freedom8623/DIY_humidifier/外壳/图片/外壳3.jpg

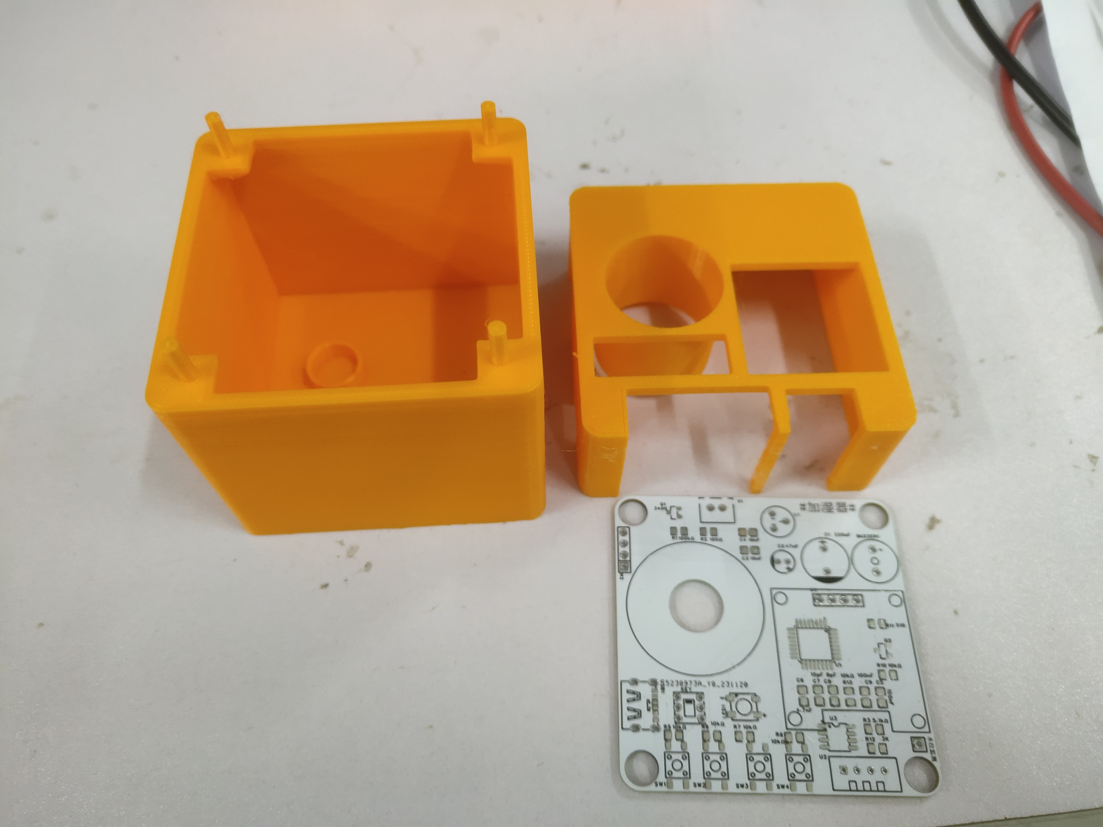
外壳/图片/外壳3.jpg
