freedom8623/DIY_humidifier/外壳/图片/外壳4.jpg

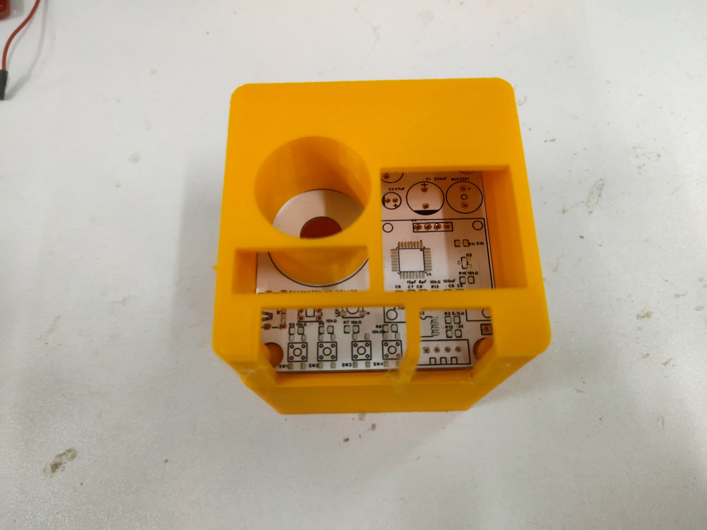
外壳/图片/外壳4.jpg
