freedom8623/DIY_humidifier/外壳/图片/外壳1.jpg

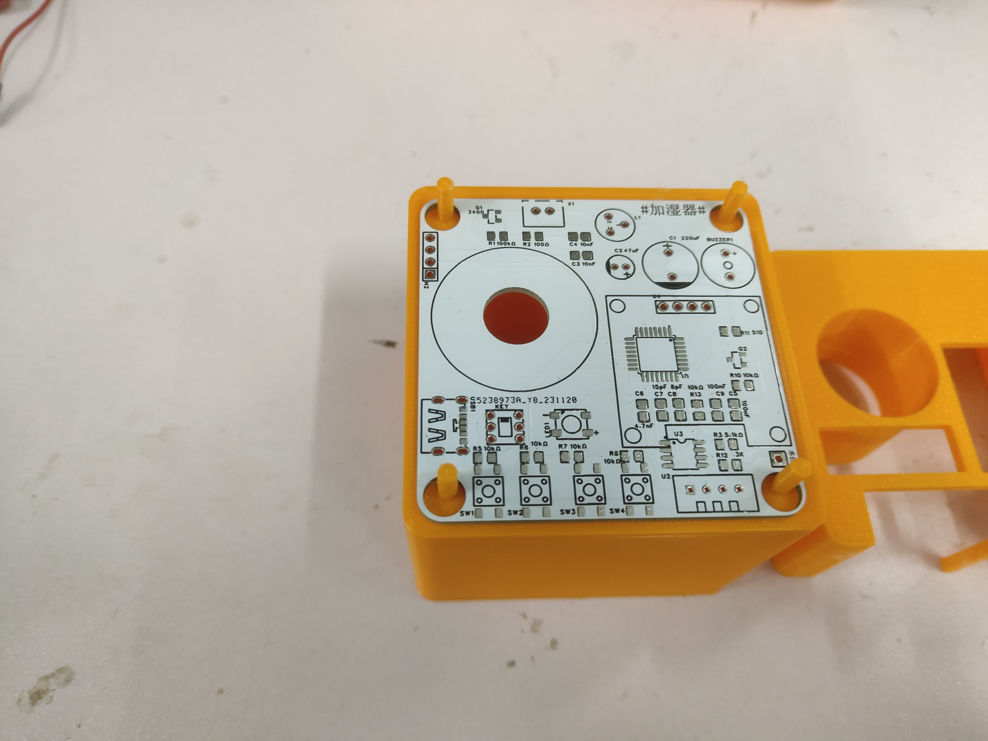
外壳/图片/外壳1.jpg
