freedom8623/DIY_humidifier/副本加湿器boom表(1).xlsx

No. | Quantity | Comment | Designator | Footprint | Value | Manufacturer Part | Manufacturer | Supplier Part | Supplier
1 | 1 | 3000Hz | BUZZER1 | BUZ-TH_BD9.6-P5.00-D0.7-FD | 3000Hz | HNB09A05 | 华能 | C96493 | LCSC
2 | 1 | 220uF | C1 | CAP-TH_BD10.0-P5.00-D1.0-FD | 220uF | RNG221M1EBK-1012 | lelon(立隆) | C311677 | LCSC
3 | 1 | 47uF | C2 | CAP-TH_BD5.0-P2.00-D0.8-FD | 47uF | 01EC1882SHG47uF16V | KNSCHA(科尼盛) | C503214 | LCSC
4 | 2 | 10nF | C3,C4 | C0805 | 10nF | 0805B103K500NT | FH(风华) | C52278 | LCSC
5 | 1 | 100nF | C5 | C0805 | 100nF | CT41G-0805-2X1-50V-0.1μF-K(N) | TORCH(火炬) | C126469 | LCSC
6 | 1 | 4.7nF | C6 | C0805 | 4.7nF | 0805B472K500NT | FH(风华) | C1744 | LCSC
7 | 1 | 15pF | C7 | C0805 | 15pF | 0805N150J500CT | Walsin(华新科) | C396747 | LCSC
8 | 1 | 8pF | C8 | C0805 | 8pF | 0805CG8R0C500NT | FH(风华) | C1839 | LCSC
9 | 1 | 100nF | C9 | C0805 | 100nF | CC0805KRX7R9BB104 | YAGEO(国巨) | C49678 | LCSC
10 | 1 | 插排 | H2 | HDR-TH_4P-P2.54-V-M |  | PZ254R-11-04P | XFCN(兴飞) | C492412 | LCSC
11 | 1 | 插排 | H3 | HDR-TH_1P-P2.54-V-M |  | PZ254V-11-01P | XFCN(兴飞) | C492400 | LCSC
12 | 1 | XKB5858-Z | KEY | SW-TH_6P-L5.8-W5.8-P2.00-LS4.5-BL |  | XKB5858-Z | XKB Connectivity(中国星坤) | C318868 | LCSC
13 | 1 | 27uH-770uH | L1 | 三脚电感 | 27uH-770uH | PDPTAT0810-2R2M | PROD(谱罗德) |  | LCSC
14 | 1 | XL-5050RGBC-WS2812B | LED1 | LED-SMD_4P-L5.0-W5.0-BL_XL-5050RGBC |  | XL-5050RGBC-WS2812B | XINGLIGHT(成兴光) | C2843785 | LCSC
15 | 1 | AO3400-HXY | Q1 | SOT-23_L2.9-W1.3-P1.90-LS2.4-BR |  | AO3400-HXY | HXY MOSFET(华轩阳电子) | C4748804 | LCSC
16 | 1 | AO3400A | Q2 | SOT-23_L2.9-W1.3-P1.90-LS2.4-BR |  | AO3400A | BORN(伯恩半导体) | C344010 | LCSC
17 | 1 | 100kΩ | R1 | R0805 | 100kΩ | 0805W8F1003T5E | UNI-ROYAL(厚声) | C149504 | LCSC
18 | 1 | 100Ω | R2 | R0805 | 100Ω | 0805W8F1000T5E | UNI-ROYAL(厚声) | C17408 | LCSC
19 | 1 | 5.1kΩ | R3 | R0805 | 5.1kΩ | 0805W8F5101T5E | UNI-ROYAL(厚声) | C27834 | LCSC
20 | 6 | 10kΩ | R5,R6,R7,R8,R10,R13 | R0805 | 10kΩ | 0805W8F1002T5E | UNI-ROYAL(厚声) | C17414 | LCSC
21 | 1 | 510Ω | R11 | R0805 | 510Ω | 0805W8F5100T5E | UNI-ROYAL(厚声) | C17734 | LCSC
22 | 1 | 3kΩ | R12 | R0805 | 3kΩ | 0805W8F3001T5E | UNI-ROYAL(厚声) | C17661 | LCSC
23 | 4 | TS-1009S-03826 | SW1,SW2,SW3,SW4 | SW-SMD_4P-L4.5-W4.5-P3.00-LS7.0 |  | TS-1009S-03826 | XUNPU(讯普) | C455243 | LCSC
24 | 1 | STC8H8K64U-LQFP32-YC | U1 | LQFP-32_L7.0-W7.0-P0.80-LS9.0-BL |  | STC8H8K64U-LQFP32-YC |  | C9900031452 | LCSC
25 | 1 | DHT11 | U2 | SENSOR-TH_DHT11 |  | DHT11 | 广州奥松 | C117051 | LCSC
26 | 1 | TC301D | U3 | SO-8_L4.9-W3.9-P1.27-LS5.9-BL |  | TC301D | NUTECH(诺泰) | C362144 | LCSC
27 | 1 | HS96L03W2C03 | U4 | OLED |  | HS96L03W2C03 | HS(汉昇) | C5248080 | LCSC
28 | 1 | TYPE-C 6P | USB1 | TYPE-C-SMD_TYPE-C-6P |  | TYPE-C 6P | SHOU HAN(首韩) | C456012 | LCSC
29 | 1 | 108KHz | X1 | 雾化片13.mm 108HZ |  | 108KHz | JST | C158012 | LCSC
30 | 1 |  | STM32H7B0VBT6 | https://item.taobao.com/item.htm?spm=a21n57.1.0.0.35c4523crgNStJ&id=732566780970&ns=1&abbucket=0&mt=
