freedom8623/DIY_humidifier/外壳/加湿器底子.SLDPRT

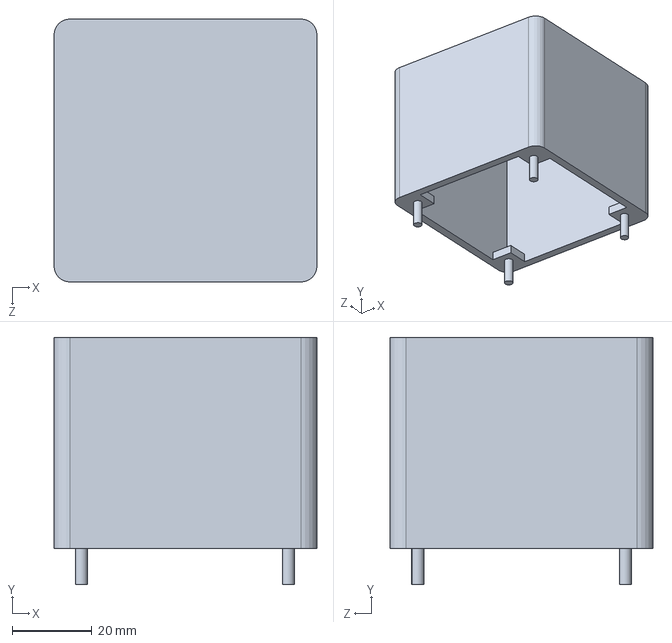
[picture p17: CAD file, 2023-12-03]
外壳/加湿器底子.SLDPRT
66.0 x 62.0 x 66.0 mm
