freedom8623/DIY_humidifier/外壳/加湿器盖子.SLDPRT

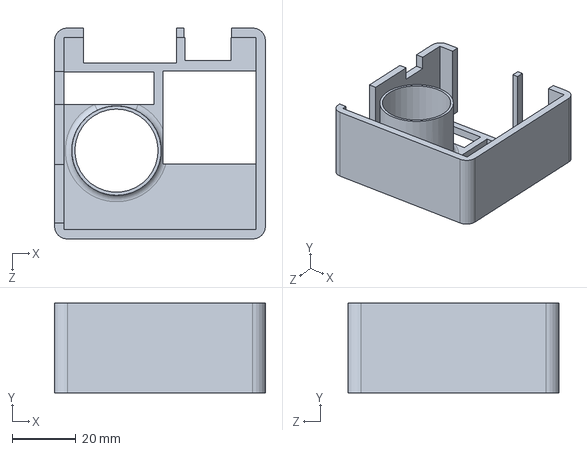
[picture p18: CAD file, 2023-12-03]
外壳/加湿器盖子.SLDPRT
66.0 x 28.0 x 66.0 mm
