freedom8623/DIY_humidifier/(list of files, cad)

Other CAD files:
Code/Objects/main.obj
Code/Objects/interrupt.obj
外壳/打印文件/打印加湿器底子.STL
Code/Objects/ws2812b.obj
外壳/打印文件/打印加湿器盖子.STL
Code/Objects/Menu.obj
Code/Objects/oled.obj
Code/Objects/Pwm.obj
Code/Objects/DHT.obj
Code/Objects/ws2812b2.obj
Code/Objects/Timer.obj
Code/Objects/Buzzer.obj
Code/Objects/key.obj
Code/Objects/Gpio.obj
Code/Objects/STARTUP.obj
Code/Objects/font.obj
Code/Objects/delay.obj
Code/Objects/DHT1.obj
Code/Objects/iic.obj
