freedom8623/DIY_humidifier/Schematic_雾化器.pdf

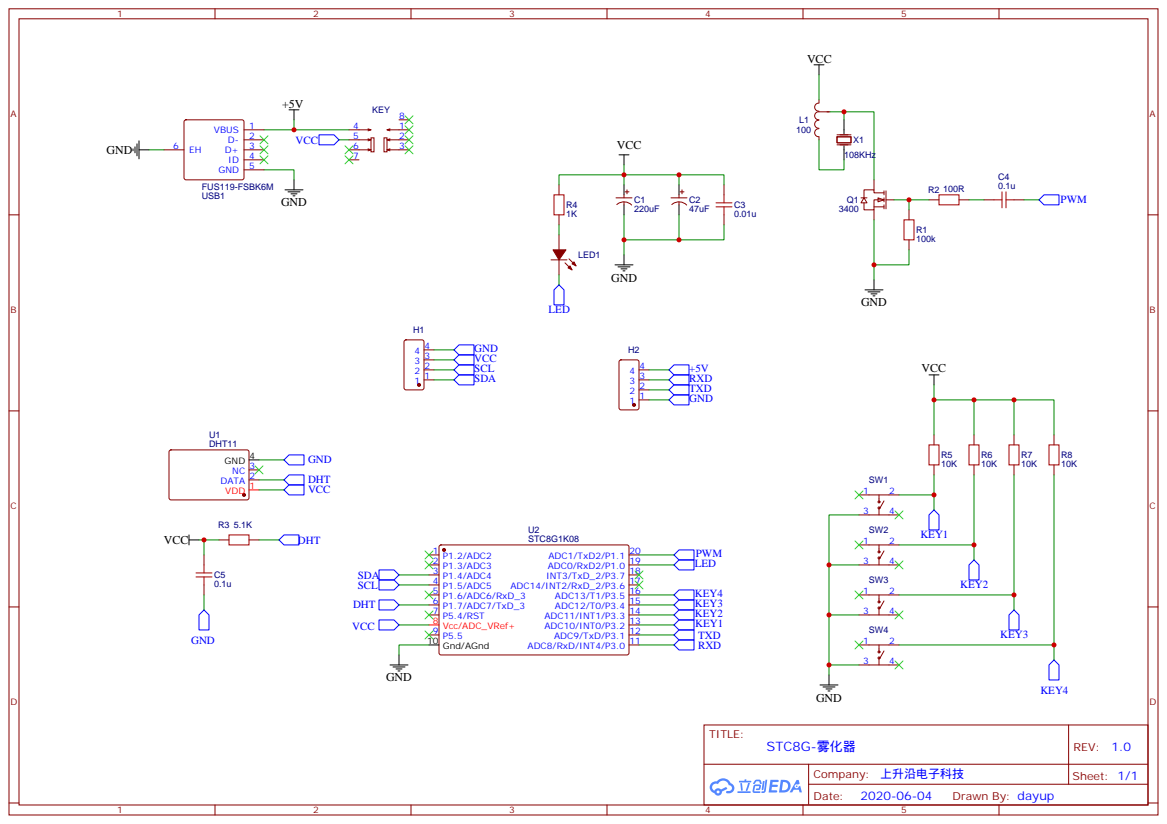
[picture p19: page 1]
