freedom8623/DIY_humidifier/(list of files, drawings)

Other design files:
PCB/ProProject_雾化加湿器_2023-11-25.epro
