freedom8623/DIY_humidifier/Code/Driver/Menu.c

#include "Menu.h"
#include "interrupt.h"
#include "pwm.h"
#include "stdlib.h"
//按键
struct keys key[];


void (*current_operation_index)(); //操作函数指针
unsigned int  func_index = 0;//获取索引值
unsigned int Water_Flag;

//温度
unsigned char rec_dat[9] = {'0','0','0','0','0','0','0','0','0'}; //储存数据
//=====================================
int limit_humit = 80;
unsigned char light_mode =0;
extern unsigned int new_light_mode;
extern unsigned int new_limit_humit;

int setting_duty = 0;
//========菜单========================
uchar showtext[16];
uchar showtext2[16];
//current索引 back返回 长按进入菜单 next下一个 +   last上一个 -  enter确定 长按关闭喷雾
extern unsigned int  humit;

Menu_table  table[29]=
{

	//一级
  {0, 0, 0, 0,  1,(*Page0)},//	进入一级菜单
	
	{1, 0, 2, 2,  3,(*Page1)},//一级界面（设置）：一级界面选择第一行
	{2, 0, 1, 1,  4,(*Page2)},//一级界面选择第二行
	
	{3, 1, 3, 3,  5,(*Page3)},//二级界面
	{4, 2, 4, 4,  6,(*Page4)},//二级界面
	
	{5, 3, 3, 3,  0,(*Page5)},//成功显示
	{6, 4, 4, 4,  0,(*Page6)},//成功显示
	
};

void Page0(void)
{
		new_limit_humit = limit_humit;
		OLED_ShowString(0,0,"=======0^0======",16);  /*第一个参数是X控制左右位置设置为8/位，第二个参数是Y上下2/位*/
		OLED_ShowString(0,2,"||",16);OLED_ShowString(112,2,"||",16);
		OLED_ShowString(0,2,"||",16);OLED_ShowString(112,2,"||",16);
		OLED_ShowString(0,4,"||",16);OLED_ShowString(112,4,"||",16);
		OLED_ShowString(0,4,"||",16);OLED_ShowString(112,4,"||",16);
		OLED_ShowString(0,6,"||",16);OLED_ShowString(112,6,"||",16);
		OLED_ShowString(0,6,"||",16);OLED_ShowString(112,6,"||",16);
	
	
		OLED_ShowChinese(32,2,4,16);/*湿度*/
		OLED_ShowChinese(48,2,5,16);
		sprintf(showtext,":%c%c%",rec_dat[0],rec_dat[1]);
		//humit = atoi(showtext);
		OLED_ShowString(64,2,showtext,16);
		
		
		OLED_ShowChinese(32,4,8,16);/*水位*/
		OLED_ShowChinese(48,4,9,16);
		OLED_ShowString(64,4,":",16);
		if(Water_Flag == 1){
			
			OLED_ShowChinese(80,4,13,16);/*×*/
		}
		if(Water_Flag == 0){
			
			OLED_ShowChinese(80,4,12,16);/*√*/
		}
	
		OLED_ShowChinese(32,6,10,16);/*雾化*/
		OLED_ShowChinese(48,6,11,16);
		OLED_ShowString(64,6,":",16);
		
		if(setting_duty == 1){
			
			OLED_ShowChinese(80,6,12,16);/*√*/
		}
		if(setting_duty == 0){
			
			OLED_ShowChinese(80,6,13,16);/*×*/
		}

}

void Page1(void)
{
		OLED_ShowChinese(48,0,6,16); /*设置*/
		OLED_ShowChinese(64,0,7,16); /*设置*/
		OLED_ShowString(0,0,"======",16);OLED_ShowString(80,0,"=====",16);
	
		OLED_ShowString(0,2,">",16);
		OLED_ShowChinese(16,2,6,16); /*设置*/
		OLED_ShowChinese(32,2,7,16); 
		OLED_ShowChinese(48,2,4,16);/*湿度*/
		OLED_ShowChinese(64,2,5,16);

		
		OLED_ShowChinese(16,4,6,16); /*设置*/
		OLED_ShowChinese(32,4,7,16); 
		OLED_ShowChinese(48,4,0,16);/*湿度*/
		OLED_ShowChinese(64,4,1,16);
	
}

void Page2(void)
{
		OLED_ShowChinese(48,0,6,16); /*设置*/
		OLED_ShowChinese(64,0,7,16); /*设置*/
		OLED_ShowString(0,0,"======",16);OLED_ShowString(80,0,"=====",16);
	
		
		OLED_ShowChinese(16,2,6,16); /*设置*/
		OLED_ShowChinese(32,2,7,16); 
		OLED_ShowChinese(48,2,4,16);/*湿度*/
		OLED_ShowChinese(64,2,5,16);

		OLED_ShowString(0,4,">",16);
		OLED_ShowChinese(16,4,6,16); /*设置*/
		OLED_ShowChinese(32,4,7,16); 
		OLED_ShowChinese(48,4,0,16);/*灯光*/
		OLED_ShowChinese(64,4,1,16);
	
}
//int setting_humit = 0;


void Page3(void)
{
		OLED_ShowChinese(48,0,6,16); /*设置*/
		OLED_ShowChinese(64,0,7,16); /*设置*/
		OLED_ShowString(0,0,"======",16);OLED_ShowString(80,0,"=====",16);
	
		
		OLED_ShowChinese(16,2,14,16); /*设置*/
		OLED_ShowChinese(32,2,15,16); 
		OLED_ShowChinese(48,2,4,16);/*湿度*/
		OLED_ShowChinese(64,2,5,16);
	
		sprintf(showtext,":%03d%",limit_humit);
		OLED_ShowString(80,2,showtext,16);
	

	
	
}

void Page4(void)
{
		OLED_ShowChinese(48,0,6,16); /*设置*/
		OLED_ShowChinese(64,0,7,16); /*设置*/
		OLED_ShowString(0,0,"======",16);OLED_ShowString(80,0,"=====",16);
	
		
		OLED_ShowChinese(16,2,14,16); /*设置*/
		OLED_ShowChinese(32,2,15,16); 
		OLED_ShowChinese(48,2,0,16);/*成功*/
		OLED_ShowChinese(64,2,1,16);
	
		sprintf(showtext2,":%03d ",light_mode);
		OLED_ShowString(80,2,showtext2,16);

	
	
}


void Page5(void)
{
		OLED_ShowChinese(48,0,6,16); /*设置*/
		OLED_ShowChinese(64,0,7,16); /*设置*/
		OLED_ShowString(0,0,"======",16);OLED_ShowString(80,0,"=====",16);
	
		
		OLED_ShowChinese(16,4,6,16); /*设置*/
		OLED_ShowChinese(32,4,7,16); 
		OLED_ShowChinese(48,4,16,16);/*成功*/
		OLED_ShowChinese(64,4,17,16);

		OLED_ShowString(80,4,"^-^",16);

	
	
	
}


void Page6(void)
{
		OLED_ShowChinese(48,0,6,16); /*设置*/
		OLED_ShowChinese(64,0,7,16); /*设置*/
		OLED_ShowString(0,0,"======",16);OLED_ShowString(80,0,"=====",16);
	
		
		OLED_ShowChinese(16,4,6,16); /*设置*/
		OLED_ShowChinese(32,4,7,16); 
		OLED_ShowChinese(48,4,16,16);/*成功*/
		OLED_ShowChinese(64,4,17,16);
	
		
		OLED_ShowString(80,4,"^-^",16);

	
	
}



//按键处理
void Key_Proc(void)
{
		if(key[0].single_flag == 1)//按键SW1 短按
	{	
		func_index=table[func_index].back;//获取enter索引号
		OLED_Clear();
		key[0].single_flag = 0;
	}

//==============================================			
	 if(key[1].single_flag == 1)//向上
	{
			func_index=table[func_index].next;//获取next索引号
			if(func_index == 3)
			{
				limit_humit++;
				if(limit_humit >= 100)limit_humit =0;
				
					
			}
			if(func_index == 4)
			{
				light_mode++;
				if(light_mode >=6)light_mode =0;
			}
			new_limit_humit=limit_humit;
			new_light_mode = light_mode;
			OLED_Clear();
			
			key[1].single_flag = 0;
	
	}
//==============================================	
	 if(key[2].single_flag == 1)//向下
	 {
		func_index=table[func_index].last;//获取last索引号
			if(func_index == 3)
			{
				limit_humit--;
				if(limit_humit <= 0)limit_humit =100;
			}
			if(func_index == 4)
			{
				
				light_mode--;
				if(light_mode <= 0)light_mode =5;
			}
			new_limit_humit=limit_humit;
			new_light_mode = light_mode;
		 
		OLED_Clear();
		key[2].single_flag = 0;
	
	}
//==============================================		
	if(key[3].single_flag == 1)//关闭
	{
		func_index=table[func_index].enter;//获取last索引号
		OLED_Clear();
		
		key[3].single_flag = 0;
	
	}
 
		if(key[3].longkey_flag == 1)//长按关闭雾化器;
	{
		  if(func_index==0)//获取last索引号
		{
				setting_duty ^= 1;
			
				if(setting_duty == 0)
				{
				
				PWMA_CCR1H = (u8)(PWM1_off >> 8); //设置占空比时间
				PWMA_CCR1L = (u8)(PWM1_off);
				
				}
				if(setting_duty == 1 )
				{
				PWMA_CCR1H = (u8)(PWM1_on >> 8); //设置占空比时间
				PWMA_CCR1L = (u8)(PWM1_on);
				}
				key[3].longkey_flag = 0;
		}
	}
	
		  if(func_index==0)//获取last索引号
	{
		if(humit >= limit_humit )
	{
				PWMA_CCR1H = (u8)(PWM1_off >> 8); //设置占空比时间
				PWMA_CCR1L = (u8)(PWM1_off);
				setting_duty =0;
	}//else
	//{			
		//		PWMA_CCR1H = (u8)(PWM1_on >> 8); //设置占空比时间
		//	PWMA_CCR1L = (u8)(PWM1_on);
		//		setting_duty =1;
	
	//	}
		
		}
	current_operation_index=table[func_index].current_operation;//执行当前索引号所对应的功能函数。
  (*current_operation_index)();
}
