freedom8623/DIY_humidifier/Code/User/main.h

#ifndef __MAIN_H_
#define __MAIN_H_
//定义主时钟
#define MAIN_Fosc		24000000ML//定义主时钟

//添加头文件
#include "stc8h.h"                 //STC8A8K单片机头文件
#include "intrins.h"
//宏定义
#define uchar unsigned char
#define uint unsigned int

#define u8 unsigned char
#define u16 unsigned int




#endif
