freedom8623/DIY_humidifier/Code/RGB_Font.h

#ifndef __RGB_FONT_H
#define __RGB_FONT_H 	 

unsigned char colorcode[][3] = {
    {256, 000, 00},
    {000, 111, 00},
    {000, 000, 11},
    {111, 111, 00},
    {000, 111, 11},
    {111, 000, 11}
};


#endif
