freedom8623/DIY_humidifier/Code/User/interrupt.c

#include "interrupt.h"
#include "ws2812b.h"
#include "Menu.h"
#include "RGB_Font.h"

//定时器2中断主要用于系统时钟
//定时器1ns
//定时器1ns

int T_Tick;
char  leddata[] = {000,256,000};
char  leddata2[] = {256,000,10};
int water_T = 0;
extern unsigned int DHT_T;
void timer2_int (void) interrupt 12
{
//	T_Tick ++;
//	
//	if(++water_T == 500) water_T = 0;
//	if(++DHT_T == 200) DHT_T = 0;
//	
//	//WS_SendData(&leddata2);


}


extern unsigned int Water_Flag;


void Alertor(unsigned int i)
{

	
			if(Water_test == 1)
		{
			
//			leddata2[1] = new_light_mode;
		switch(i){
		case 0:
		WS_SendData(colorcode[0]);
		break;
	
		case 1:
		WS_SendData(colorcode[1]);
		break;
	
		case 2:
		WS_SendData(colorcode[2]);
		break;
	
		case 3:
		WS_SendData(colorcode[3]);
		break;
	
		case 4:
		WS_SendData(colorcode[4]);
		break;
	
		case 5:
		WS_SendData(colorcode[5]);
		break;
		}	
		}
		if(Water_test == 0)
		{
			Water_Flag=0;
			WS_SendData(&leddata);		
		}
}

//定时器3中断主要用于按键中断
struct keys key[4] = {0,0,0};


//按键引脚定义
sbit KEY1 = P3^2;
sbit KEY2 = P3^3;
sbit KEY3 = P3^4;
sbit KEY4 = P3^5;

void timer3_int(void) interrupt 19
{
	uchar i;
	
	    	//第一步读取按键状态
			key[0].key_sta = KEY1;
			key[1].key_sta = KEY2;
			key[2].key_sta = KEY3;
			key[3].key_sta = KEY4;
	
		//遍历
		for(i = 0;i <4; i++)
		{
			switch(key[i].judge_sta)
			{
				case 0 :
				{
					//第一步是为了消抖
				if(key[i].key_sta == 0)
					{
					key[i].judge_sta = 1;
					key[i].key_time = 0;
					
					}
				}
					break;
					
				case 1 :
				{
				//如果key_sta == 0证明按键确实被按下
				if(key[i].key_sta == 0)
					{
						key[i].judge_sta = 2;
						
					}
				else
					{
					key[i].judge_sta = 0;
					}
				}
				break;
									
				case 2 :
				{
					key[i].key_time++;
					//证明按下后松手
						if(key[i].key_sta == 1)
					{
						key[i].judge_sta = 0;
								//确定是否为短按
						if(key[i].key_time<=100)
							{
							key[i].single_flag = 1;
							}else
							{
							key[i].longkey_flag = 1;
							}
						}
				break;
				}
									
			}				
	
	}
}
