freedom8623/DIY_humidifier/Code/User/Timer.c

#include "Timer.h"




//定时器2初始化,
#define ET2 0x04
void    Timer2_init(void) //1ns @24Mhz
{
	AUXR &= 0xFB;		//定时器时钟12T模式
	T2L = 0x30;		//设置定时初始值
	T2H = 0xF8;		//设置定时初始值
	AUXR |= 0x10;		//定时器2开始计时
	
	IE2  |=  ET2;       //允许中断
	EA = 1;//使能中断
} 

#define ET3 0x20
//定时器3初始化用于按键
void Timer3Init(void)		//10毫秒@24.000MHz
{
	T4T3M &= 0xFD;		//定时器时钟12T模式
	T3L = 0xE0;		//设置定时初始值
	T3H = 0xB1;		//设置定时初始值
	IE2  |=  ET3;       //允许中断
	T4T3M |= 0x08;		//定时器3开始计时
}
