freedom8623/DIY_humidifier/(commit log)

2023-12-03 提交自制DIY_加湿器，用于备份留存学习
    [ProProject_雾化加湿器_2023-11-25.epro, 加湿器boom表.xlsx, 加湿器底子.SLDPRT, 加湿器盖子.SLDPRT, 打印加湿器底子.STL, 打印加湿器盖子.STL]
2023-12-04 初步建立加湿器代码框架
    [DHT.obj, Gpio.obj, Pwm.obj, STARTUP.obj, Timer.obj, main.obj, oled.obj]
2023-12-05 修改了雾化器电路图以及oled模块
    [DHT.obj, Gpio.obj, ProProject_雾化加湿器_2023-11-25.epro, Pwm.obj, STARTUP.obj, Timer.obj, delay.obj, font.obj]
2023-12-13 更新了多级菜单，完善基本逻辑
    [Buzzer.obj, DHT.obj, DHT1.obj, Gpio.obj, IO_Mode.OBJ, Menu.obj, Pwm.obj, STARTUP.obj]
2023-12-14 完成基本水位检测以及pwm控制
    [Buzzer.obj, DHT.obj, Gpio.obj, Menu.obj, Pwm.obj, STARTUP.obj, Timer.obj, interrupt.obj]
2023-12-14 进行了加湿器的完善。1.配置PWMA外部引脚冲突（待验证） 2.添加了湿度判断是否停止加湿器
    [IO_Mode.OBJ, Menu.obj, Pwm.obj, interrupt.obj, 正弦表计算.xls]
2023-12-16 增加了灯光模式
    [DHT.obj, Menu.obj, Pwm.obj, interrupt.obj, main.obj, oled.obj, ws2812b.obj]
